Joshua2046c/replicator-project/product/gallery/cover-iso.jpg

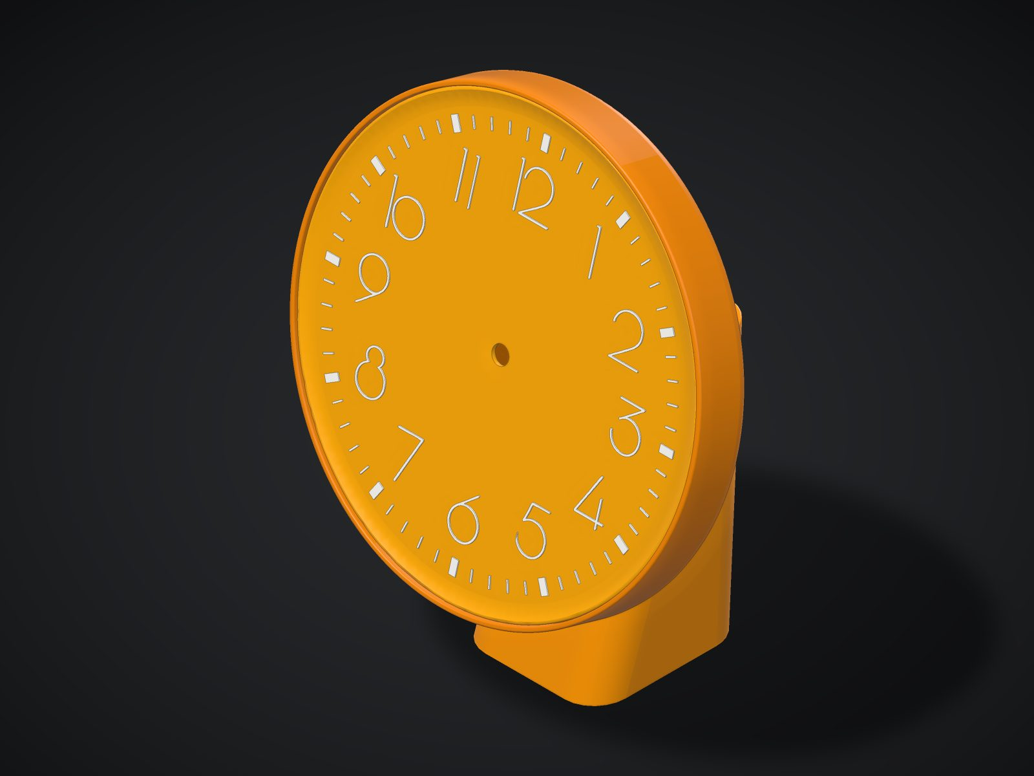
product/gallery/cover-iso.jpg
