Joshua2046c/replicator-project/product/README.md

# 伸颈式收纳座钟

按参考图制作黄色圆盘、白色凸起刻度的座钟，三个主要件为顶部可收纳的底座、加厚钟主体，以及被钟主体包住的嵌套盘面，另有独立小方定位块。盘面底面保持平整，外缘平滑翘起；按最新要求在正面增加白色浮雕刻度及数字。

默认布局为12个整点宽条、48条分钟细线及正向排列的1–12数字，凸起0.6 mm。刻度中心半径101 mm，小时条8×4 mm、分钟线6×0.9 mm；数字中心半径77 mm。数字严格以用户图片的白色轮廓描摹，不使用替代字体，保留细线圆头、开口4、3的折线、8腰部及10中较小的圆形0等特征；统一按原图180像素对应25 mm缩放，较原版28 mm略缩小，各数字原始比例保持一致。白色刻度与数字各自分组，双色打印时与盘面一起制造。最低指针下表面应高于平盘面至少1.1 mm，以留出0.5 mm运转间隙；尚需用实际机芯及指针试装确认。

用户已澄清：钟芯轴长 14 mm，最长指针 90 mm。补充图片中分针另标注 102 mm，因此默认采用直径 216 mm 的纯平扫掠区，兼容这两个长度，不改写用户的 90 mm 要求。

根据最新标注图，底座前上部改成向前伸出的脖子，下方根部圆滑内凹并接到展开的底脚；靠钟体的伸颈端部改为直角，不做圆弧收头，底部默认保留20 mm直线段并与贴合面成90°，后侧底部内收 8 mm。底座落地约 84 × 92 mm、高 160 mm，总包络约 84 × 103.15 × 160 mm，侧边 R18、口沿 R0.8。钟体外径 240 mm、后仰 16°、厚 32 mm，后缘 R7 圆角、前缘 R1 圆角、前口内缘 R0.8 圆角；盘面外唇 R1、背缘 R0.5，均为连续圆滑过渡；整机高约 291.93 mm；盘面厚 2.4 mm、边缘翘起 3 mm。这些具体尺寸为可调默认值。

取消一体的大方榫及榫根。独立方定位块默认 12 × 12 × 5 mm；钟体背面预留 12.5 mm 方形、深 1.2 mm 的浅凹槽，底座对应凹槽深 4.2 mm。两端各留 0.2 mm 胶层空间、侧面各留 0.25 mm 间隙。用户采用粘合方式组装，定位块藏在贴合面内部，钟体背板凹槽处剩余厚度 2.3 mm，不通入机芯腔。默认黄色 PETG / FDM；胶合强度需实物验证。

后方收纳孔底面按用户横线抬高，默认离底部 35 mm，顶部到孔底的收纳深度为 125 mm；35 mm 为按标注图估算的可调值。

钟芯完全隐藏在封闭的钟体内，取消背面检修镂空。内部仍保留安装腔；维护时从前面取下盘面和固定在盘面背后的钟芯，换电池后再装回。盘面坐在钟体台阶上，少量可移除薄双面胶保留可拆性。

不使用开发板或自定义 PCB，使用独立电池式通用石英钟芯。外壳空间依据为 56 × 56 × 17 mm 类别：https://www.m-p.co.uk/muk/parts/movements-quartz.htm 。该网页用作外形和安装参考，采购仍遵循用户的 14 mm 轴长，不选择网页的 12 mm 轴型号。中央孔默认 10 mm，适配供应商资料中的安装方式；外壳预留 64 × 64 × 22.5 mm 净空间。14 mm 总轴长无法单独证明螺纹段及针孔适配，装配前用实物检查垫圈、螺母及指针。未取得可靠钟芯 STEP，不生成代用钟芯实体。

验收：三个主要结构件及独立方定位块；白色凸起刻度和数字完整、无错位；伸颈侧面造型；顶部收纳口可用；浅槽定位粘合；盘面嵌套无穿插；钟芯可装入及从正面更换电池；交付包含白色浮雕分组的装配 STEP。

整圈外框需呈连续圆形，不得出现可见多边形折角。盘面和表身采用不超过3°的真实相切曲面片细分以约束预览网格，圆弧与尺寸保持不变；这不是增大边缘倒角。
