Joshua2046c/replicator-project/design/clock/README.md

# 伸颈式收纳座钟

## Must satisfy
三个主要结构件 base、body、dial，加独立小方定位块 locator，四个主体制造件；盘面另含白色刻度和数字浮雕分组。用户要求缩小方桩并与钟体分体，以浅凹孔定位粘合；底座前上部采用伸脖子造型，下方根部圆滑内凹；与钟体背面相接的端部为直角收头，不做圆弧过渡。盘面后仰16°；钟体直径240 mm、厚32 mm、后缘R7、前缘R1、前口内缘R0.8圆角；盘面外唇R1、背缘R0.5圆角。底座高160 mm、宽84 mm，落地前后约92 mm，总包络深103.15 mm；后侧底部内收8 mm，根部与下部侧边R18；贴合端面两侧棱线保持锐利。整机高291.93 mm，钟体下缘离桌面54.31 mm。
用户轴长14 mm、最长针90 mm；直径216 mm平区兼容参考图片另标102 mm分针。机芯完全隐藏，壳体背板3.5 mm，浅槽底剩2.3 mm，不开后检修孔。内部预留64×64×22.5 mm；参考 https://www.m-p.co.uk/muk/parts/movements-quartz.htm 的56×56×17 mm类别，不采购12 mm轴型号。材料默认黄色PETG，无控制板及外部接线。

## Making and assembly
盘面增加白色凸起0.6 mm的浮雕：12个8×4 mm小时标记、48个6×0.9 mm分钟标记，中心半径101 mm；1–12数字正向排列、原图轮廓描摹、名义字高25 mm、中心半径77 mm。黄色盘面与白色markings、numerals按现有装配位置作为同一多材料件导入切片器；白色区域从盘面背面以上2.4 mm开始，向上到3.0 mm。多材料打印逐区域分色，不能把同高度的黄色翘边也全部改白。单色打印可将浮雕与盘面合并后涂白。保留各区域相对位置，不逐个落地排列。
最低指针下表面需离平盘面至少1.1 mm，才有0.5 mm浮雕上方间隙；14 mm总轴长无法证明实际指针高度，装配前手动转动一整圈检查。尚未完成实物指针干涉验证。
底座底面朝下打印，侧后壁名义3 mm、收纳孔底面离落地面35 mm（按用户横线估算），收纳深度125 mm，收纳口沿R0.8，根部与下部侧边R18；连接端部保留直角，修整支撑时不要磨成圆头。前伸脖子下方有悬垂，切片时从底板添加支撑，保护胶合定位面，去支撑后修整毛刺。收纳腔与胶合凹槽分开。
钟体与小方块分别打印；钟体可调整为背面朝下，让盘面台阶向上，浅凹槽处检查桥接；如正面朝下，则对内部凹处采用支撑并保护嵌套台阶。小方块以12×12 mm大面落地，厚5 mm，棱边倒角0.2 mm。盘面背面朝下，中心厚2.4 mm、翘边基准轮廓升高3 mm（唇口圆化后最高点略低）；直径234 mm，打印机需足够幅面。先试配再修整，尚未实物打印。
独立定位块12×12×5 mm，钟体槽12.5×12.5×1.2 mm，底座槽12.5×12.5×4.2 mm。装配后进入钟体1 mm、底座4 mm；两端各有0.2 mm胶层空间、单边侧隙0.25 mm。先干装检查，再用用户选定且适合打印材料的胶粘合；保持16°贴合角并支撑钟体直到固化。胶种、表面处理和实际承载强度需实物试验；方块主要用于定位，不把它当作可拔插榫头。搬动始终托住底座。
先完成底座与钟体胶合，再将机芯轴穿过盘面，使用原配垫圈螺母安装。盘面连同机芯从正面放入钟体，台阶贴0.2 mm可移除胶点，不用整圈永久胶。盘面与前口单边径向间隙0.3 mm、轴向台阶间隙0.2 mm。
换电池时保持底座与钟体粘合，支撑整机并使盘面朝上，借助小吸盘轻轻取出盘面与机芯，换电池并更换胶点后复装；避免拉扯指针。不再尝试拔下钟体。

## Inspection
伸颈末端采用20 mm直线段，侧视与贴合端面的夹角实测90°（容差0.01°通过）；端部不倒圆，根部仍为相切曲线。已检查端部侧视和斜视。底座、钟体、方定位块精确配对无体积干涉；底座与钟体接触，方块两端最小间隙各0.2 mm。当前按用户连续回退要求采用12×12×5 mm定位块及1.2 mm深钟体槽。
整圈轮廓采用最大3°的真实旋转曲面片，连续相切，不使用多边形轮廓。细分前后以1e-9精度积分验证体积差小于0.001 mm³，每个主体仍为一个有效实体。细分只改变曲面拓扑，圆弧、接合面、数字与刻度保持原形。全装配79实体有效；本轮自动配对检查有超时项，不将其记为已通过，原形状的装配检查见前序记录。
外露边缘已改为真实相切圆角，保留直径216 mm的纯平扫针区与原嵌套台阶；背部由平倒角改为R7圆弧。已检查正面、斜前方与背面预览，内核验证79个实体有效。body_rear_chamfer、body_front_chamfer为兼容既有参数而保留的名称，现在驱动圆角半径。背部圆角打印初始几层有悬垂，切片时检查支撑需求。
本轮数字轮廓直接提取自用户参考图片，12组数字包含15个字符实体，轮廓数据记录原图哈希与像素裁切框。描边简化容差0.5像素，在当前尺寸对应约0.0694 mm；不使用替代字体，不添加原图没有的笔画。名义字高从28 mm减为25 mm，原图中各字的比例保留。浮雕沿盘面朝外方向凸起0.6 mm。已检查正面和数字3的局部斜视；盘面、刻度、数字三组精确干涉检查通过，无体积交叠。
保留原有60个刻度和四个主体件。前序已经测量收纳底面35 mm、盘面嵌套间隙0.2 mm。实际指针高度和胶合承载仍需试装。

## Open
14 mm为钟芯总轴长，螺纹长度和针孔需实物量测；10 mm轴孔沿用供应商参考。机芯和指针不建代用实体；STEP含四个主体制造件，以及白色刻度和数字分组（与盘面一起打印）。
参数同步：body_tilt_angle与base_contact_angle一致；钟体背中心Y=-10+8*tan(angle)，Z=168。浅槽中心在钟体未旋转框架Y=-24；base_locator_drop=24*cos(angle)-8；底座槽本地中心为(0,-drop*tan(angle),160-drop)。定位块中心从钟体槽口沿朝前法向后退1.5 mm，旋转X=90-angle；盘面背面从钟体背中心沿朝前法向前进26 mm，旋转X=90-angle。修改角度或定位位置须同步这些放置参数。

浮雕放置：与盘面同角度，其本地Z=0面置于盘面正面的Z=2.4 mm平面；修改盘面位置、厚度或倾角时同步markings、numerals两组。
