Joshua2046c/replicator-project/product/gallery/codex-image-2026-10-1-20-05-23.jpg

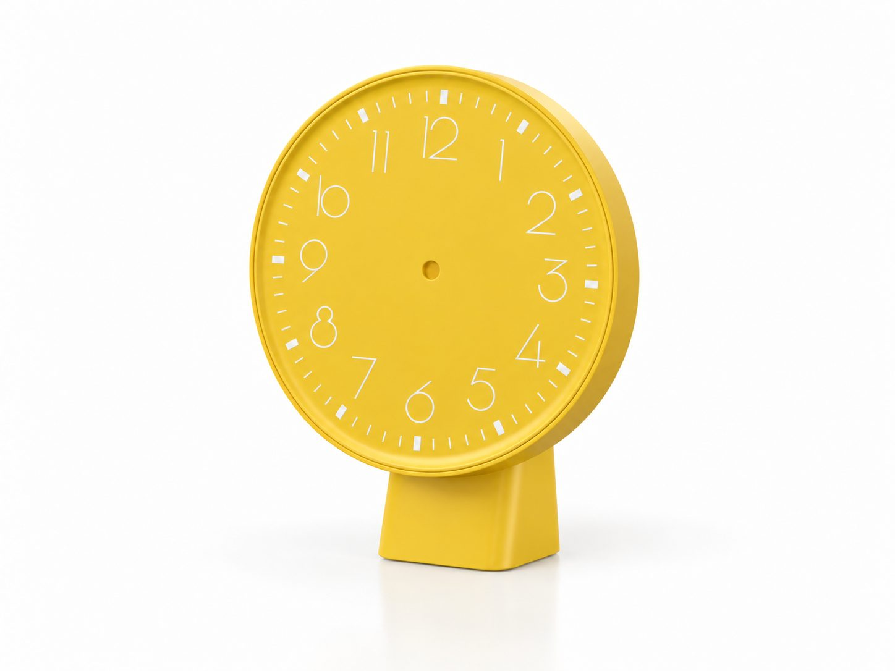
product/gallery/codex-image-2026-10-1-20-05-23.jpg
