Joshua2046c/replicator-project/manufacturing/clock/releases/export-fe7c0c097382e9653f172104423d2a58/model.step

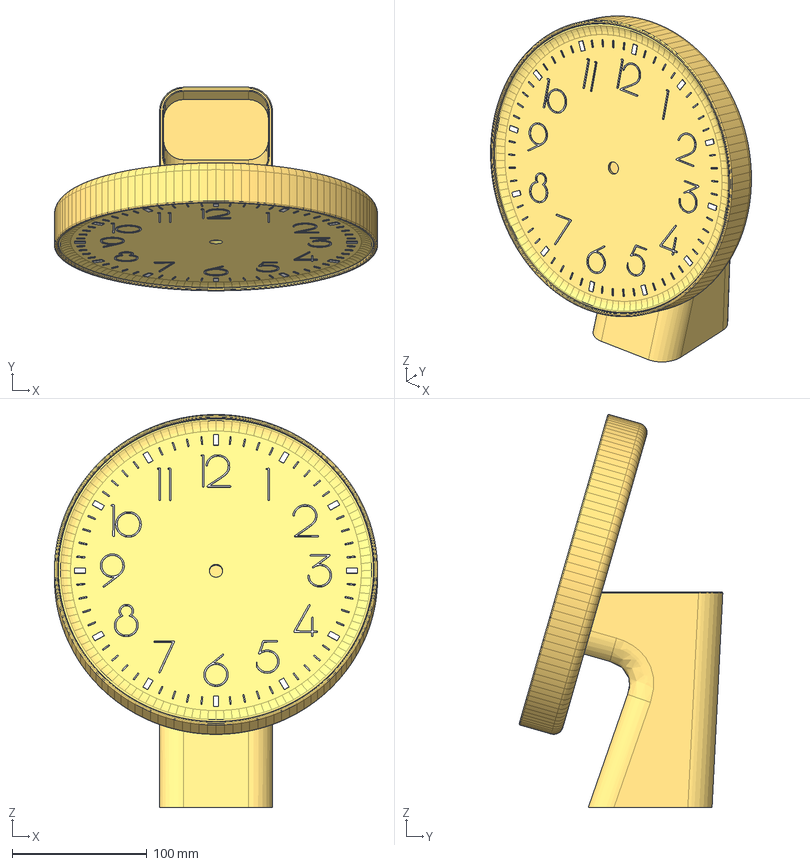
[picture p4: CAD file, 2026-09-29]
manufacturing/clock/releases/export-fe7c0c097382e9653f172104423d2a58/model.step
240.0 x 151.3 x 291.9 mm
base
Recessed_clock_body
Nested_dial
Separate_square_locator
