Joshua2046c/replicator-project/(commit log)

2026-09-25 feat(cad): build and export three-part storage clock
    [model.step]
2026-09-25 feat(cad): refine clock proportions and conceal movement
    [model.step]
2026-09-26 fix(cad): conceal clock joint and increase backward tilt
    [model.step]
2026-09-26 feat(cad): add projecting neck and separate glue locator
    [model.step]
2026-09-26 fix(cad): raise storage pocket floor to marked height
    [model.step]
2026-09-26 feat(cad): add white raised clock ticks and numerals
    [model.step]
2026-09-26 fix(cad): trace reference numerals and reduce their size
    [model.step]
2026-09-26 fix(cad): round dial and clock body edges
    [model.step]
2026-09-26 fix(cad): eliminate visible facets on circular clock perimeter
    [model.step]
2026-09-26 fix(cad): enlarge square locator and deepen clock back recess
    [model.step]
2026-09-29 fix(cad): restore previous clock neck profile and export
    [model.step]
2026-09-29 fix(cad): keep clock neck connection square
    [model.step]
